kaszmirek/LinefollowerKaszmir/README.md

# LinefollowerKaszmir
robot typu line follower
