kaszmirek/LinefollowerKaszmir/Kaszmir/Kaszmir/KaszmirSensors/KaszmirSensors.step

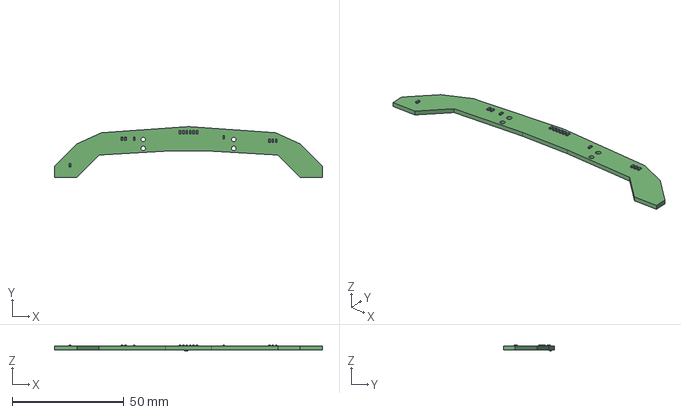
[picture p9: CAD file, 2021-05-30]
Kaszmir/Kaszmir/KaszmirSensors/KaszmirSensors.step
120.0 x 22.8 x 2.60 mm
