kaszmirek/LinefollowerKaszmir/Kaszmir/kicad-libs-master/kicad-libs-master/HYC04-TF09-200.step

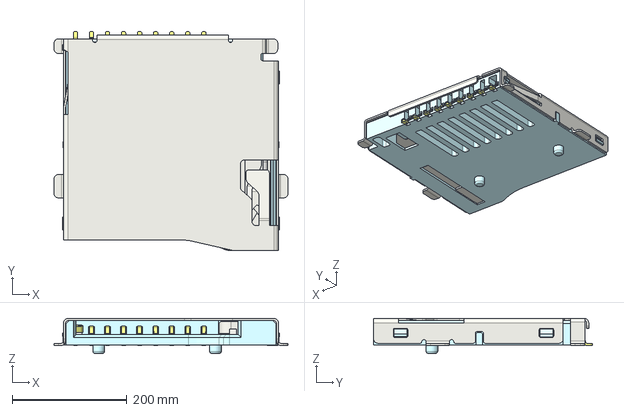
[picture p10: CAD file, 2021-05-30]
Kaszmir/kicad-libs-master/kicad-libs-master/HYC04-TF09-200.step
407.4 x 381.0 x 61.0 mm
