kaszmirek/LinefollowerKaszmir/Kaszmir_Inventor/pololu-2218-micro-metal-gearmotor-with-extended-motor-shaft-1.snapshot.1/Pololu #2218 Micro Metal Gearmotor HP.stp

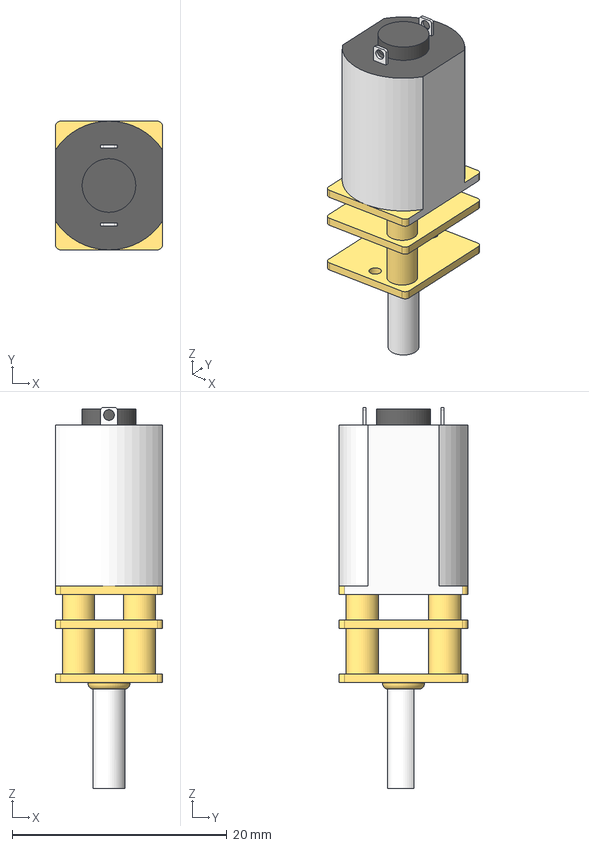
[picture p11: CAD file, 2021-05-30]
Kaszmir_Inventor/pololu-2218-micro-metal-gearmotor-with-extended-motor-shaft-1.snapshot.1/Pololu #2218 Micro Metal Gearmotor HP.stp
10.0 x 12.0 x 35.5 mm
