kaszmirek/LinefollowerKaszmir/Kaszmir_Inventor/pololu-micro-motor-bracket-1.snapshot.3/micro-motor-bracket.SLDPRT

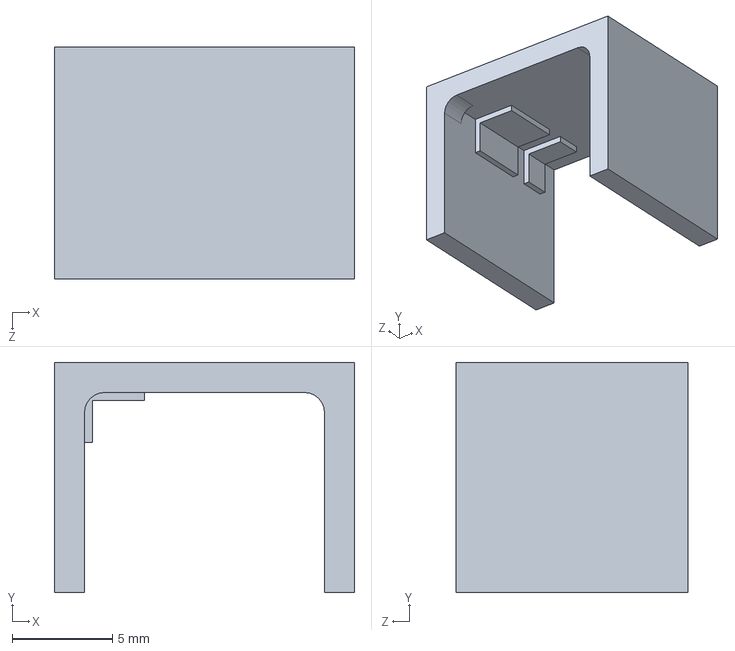
[picture p12: CAD file, 2021-05-30]
Kaszmir_Inventor/pololu-micro-motor-bracket-1.snapshot.3/micro-motor-bracket.SLDPRT
15.0 x 11.5 x 11.6 mm
