kaszmirek/LinefollowerKaszmir/Kaszmir_Inventor/wheel-solarbotics-rw2i-internally-mounted-1.snapshot.4/STEP/felga_solarbotics.STEP

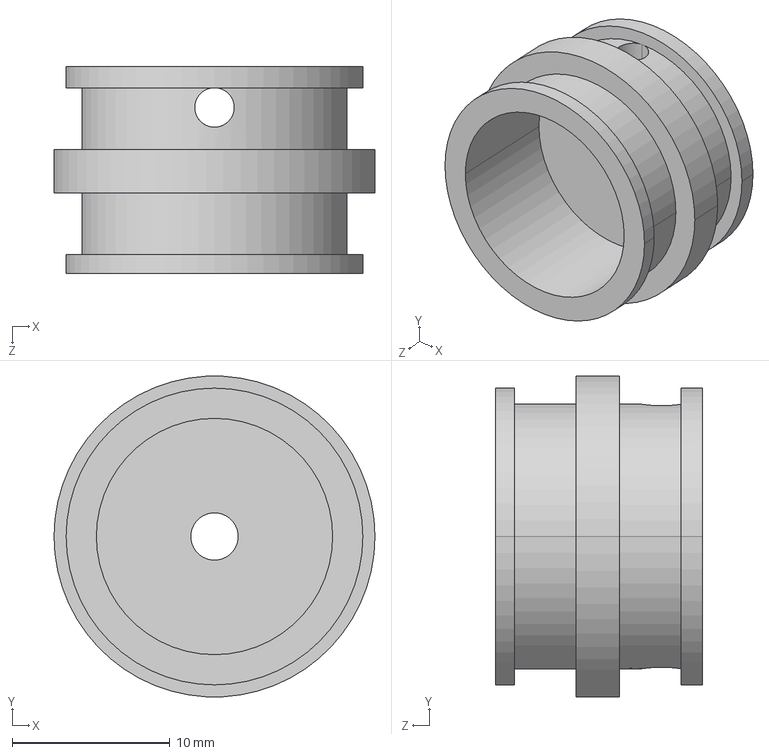
[picture p13: CAD file, 2021-05-30]
Kaszmir_Inventor/wheel-solarbotics-rw2i-internally-mounted-1.snapshot.4/STEP/felga_solarbotics.STEP
20.4 x 20.4 x 13.1 mm
