kaszmirek/LinefollowerKaszmir/Kaszmir/kicad-libs-master/kicad-libs-master/cap-size-code-g-v.stp

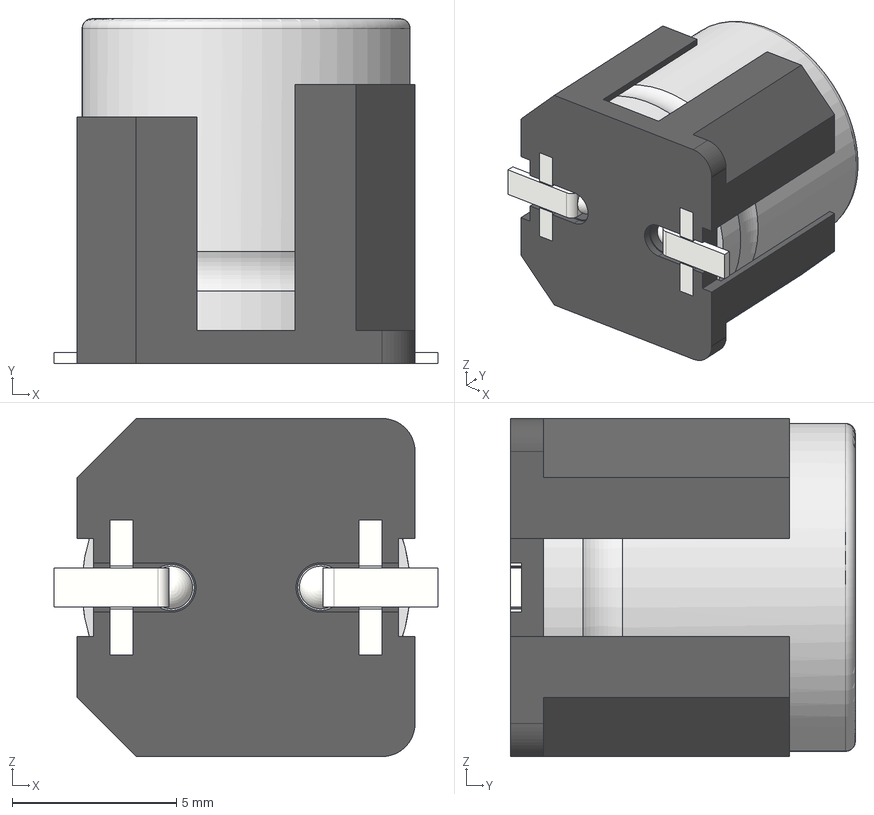
[picture p14: CAD file, 2021-05-30]
Kaszmir/kicad-libs-master/kicad-libs-master/cap-size-code-g-v.stp
11.7 x 10.5 x 10.3 mm
ケースΦ10x9.5L SIDE CODE G
耐振品座版Φ10 SIZE CODE G
耐振品座版用補助端子Φ10 SIZE CODE G x 2
耐振品リード線Φ10 SIZE CODE G x 2
