kaszmirek/LinefollowerKaszmir/Kaszmir_Inventor/pololu-micro-motor-bracket-1.snapshot.3/Bracket.IGS

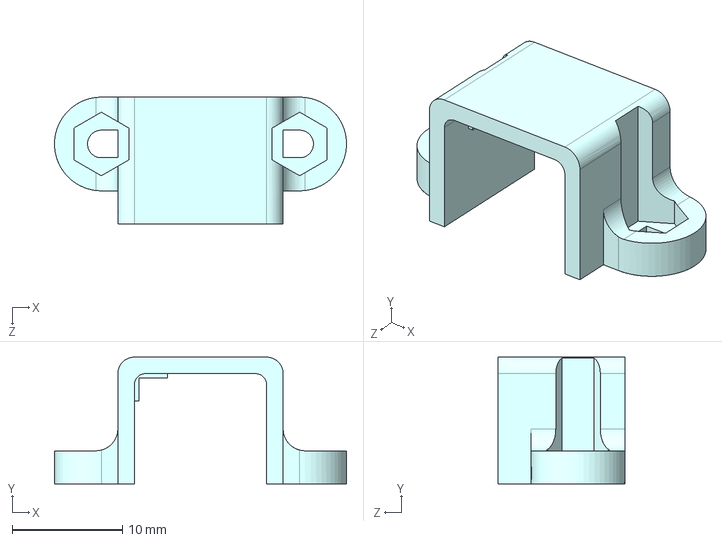
[picture p15: CAD file, 2021-05-30]
Kaszmir_Inventor/pololu-micro-motor-bracket-1.snapshot.3/Bracket.IGS
26.5 x 11.5 x 11.5 mm
