kaszmirek/LinefollowerKaszmir/Kaszmir/kicad-libs-master/kicad-libs-master/1TS003B.step

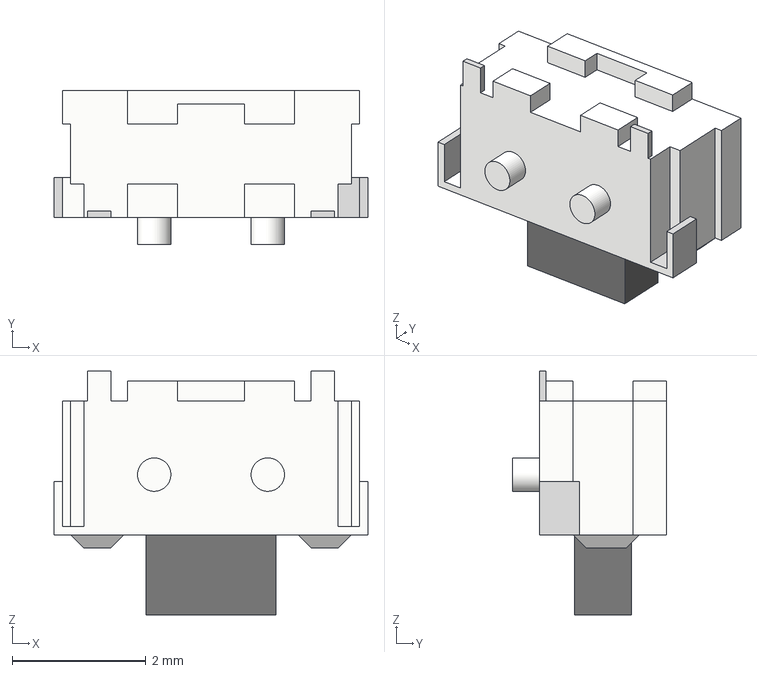
[picture p17: CAD file, 2021-05-30]
Kaszmir/kicad-libs-master/kicad-libs-master/1TS003B.step
4.70 x 2.30 x 3.65 mm
