kaszmirek/LinefollowerKaszmir/Kaszmir_Inventor/pololu-micro-motor-bracket-1.snapshot.3/Micro-Motor-Complet.IGS

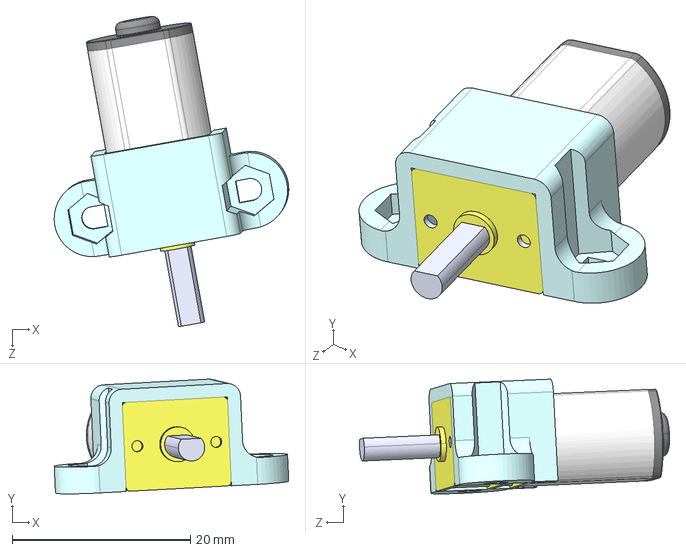
[picture p18: CAD file, 2021-05-30]
Kaszmir_Inventor/pololu-micro-motor-bracket-1.snapshot.3/Micro-Motor-Complet.IGS
26.3 x 12.9 x 34.8 mm
