kaszmirek/LinefollowerKaszmir/Kaszmir_Inventor/wheel-solarbotics-rw2i-internally-mounted-1.snapshot.4/STEP/opona solarbotics.STEP

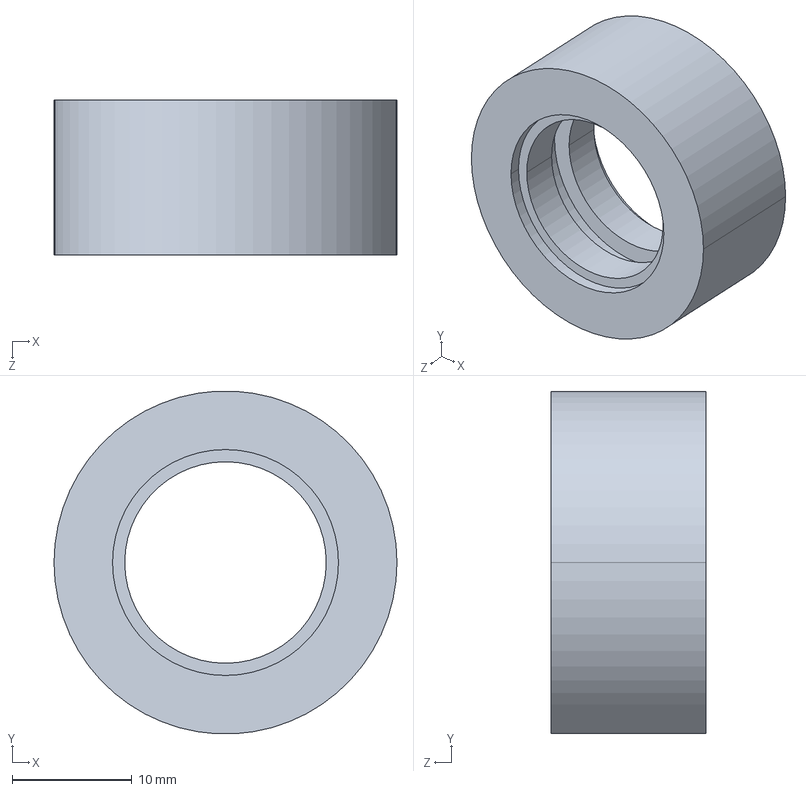
[picture p19: CAD file, 2021-05-30]
Kaszmir_Inventor/wheel-solarbotics-rw2i-internally-mounted-1.snapshot.4/STEP/opona solarbotics.STEP
28.6 x 28.6 x 13.0 mm
