kaszmirek/LinefollowerKaszmir/Kaszmir/kicad-libs-master/kicad-libs-master/WL-SFSW-155124M173200.stp

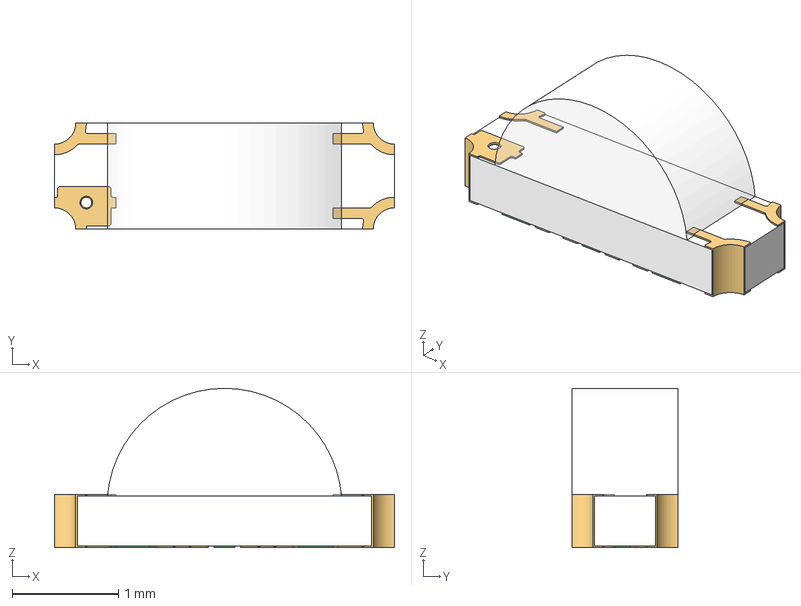
[picture p20: CAD file, 2021-05-30]
Kaszmir/kicad-libs-master/kicad-libs-master/WL-SFSW-155124M173200.stp
3.20 x 1.00 x 1.50 mm
housing
contacts
cap
