kaszmirek/LinefollowerKaszmir/(list of files, cad)

Other CAD files:
Kaszmir/Kaszmir/COMPOUND.ipt
Kaszmir/Kaszmir/C_0603_1608Metric.iam
Kaszmir/Kaszmir/Kaszmir.iam
Kaszmir/Kaszmir/KaszmirSensors/Bracket.ipt
Kaszmir/Kaszmir/KaszmirSensors/COMPOUND.ipt
Kaszmir/Kaszmir/KaszmirSensors/KaszmirSensors.iam
Kaszmir/Kaszmir/KaszmirSensors/R_0603_1608Metric.iam
Kaszmir/Kaszmir/KaszmirSensors/SOLID.ipt
Kaszmir/Kaszmir/LED_0603_1608Metric.iam
Kaszmir/Kaszmir/LQFP-64_10x10mm_P0.5mm.iam
Kaszmir/Kaszmir/PinHeader_1x02_P2.54mm_Vertical.iam
Kaszmir/Kaszmir/PinHeader_1x05_P2.54mm_Vertical.iam
Kaszmir/Kaszmir/PinHeader_1x08_P2.54mm_Vertical.iam
Kaszmir/Kaszmir/PinSocket_1x06_P2.54mm_Vertical.iam
Kaszmir/Kaszmir/R_0603_1608Metric.iam
Kaszmir/Kaszmir/SOLID.ipt
Kaszmir/Kaszmir/SOLID_1.ipt
Kaszmir/Kaszmir/SOLID_2.ipt
Kaszmir/Kaszmir/SOLID_3.ipt
Kaszmir/Kaszmir/SOLID_4.ipt
Kaszmir/Kaszmir/SOLID_5.ipt
Kaszmir/Kaszmir/SOLID_6.ipt
Kaszmir/Kaszmir/SOLID_7.ipt
Kaszmir/Kaszmir/SOLID_8.ipt
Kaszmir/Kaszmir/SOLID_9.ipt
Kaszmir/Kaszmir/SOT-23.iam
Kaszmir/Kaszmir/SW_SPST_B3U-1000P-B.iam
Kaszmir_Inventor/KaszmirCały.iam
Kaszmir_Inventor/OldVersions/KaszmirCały.0001.iam
Kaszmir_Inventor/listwa_weglowa.ipt
Kaszmir_Inventor/pololu-2218-micro-metal-gearmotor-with-extended-motor-shaft-1.snapshot.1/Pololu #2218 Micro Metal Gearmotor HP.ipt
Kaszmir_Inventor/pololu-micro-motor-bracket-1.snapshot.3/Bracket.STL
Kaszmir_Inventor/pololu-micro-motor-bracket-1.snapshot.3/Micro-Motor-Complet.STL
Kaszmir_Inventor/wheel-solarbotics-rw2i-internally-mounted-1.snapshot.4/STEP/koło_solarbotics.ipt
Kaszmir_Inventor/wheel-solarbotics-rw2i-internally-mounted-1.snapshot.4/felga_solarbotics.SLDPRT
Kaszmir_Inventor/wheel-solarbotics-rw2i-internally-mounted-1.snapshot.4/koło_solarbotics.SLDASM
Kaszmir_Inventor/wheel-solarbotics-rw2i-internally-mounted-1.snapshot.4/opona solarbotics.SLDPRT
