kaszmirek/LinefollowerKaszmir/Kaszmir/Kaszmir/Kaszmir.pdf

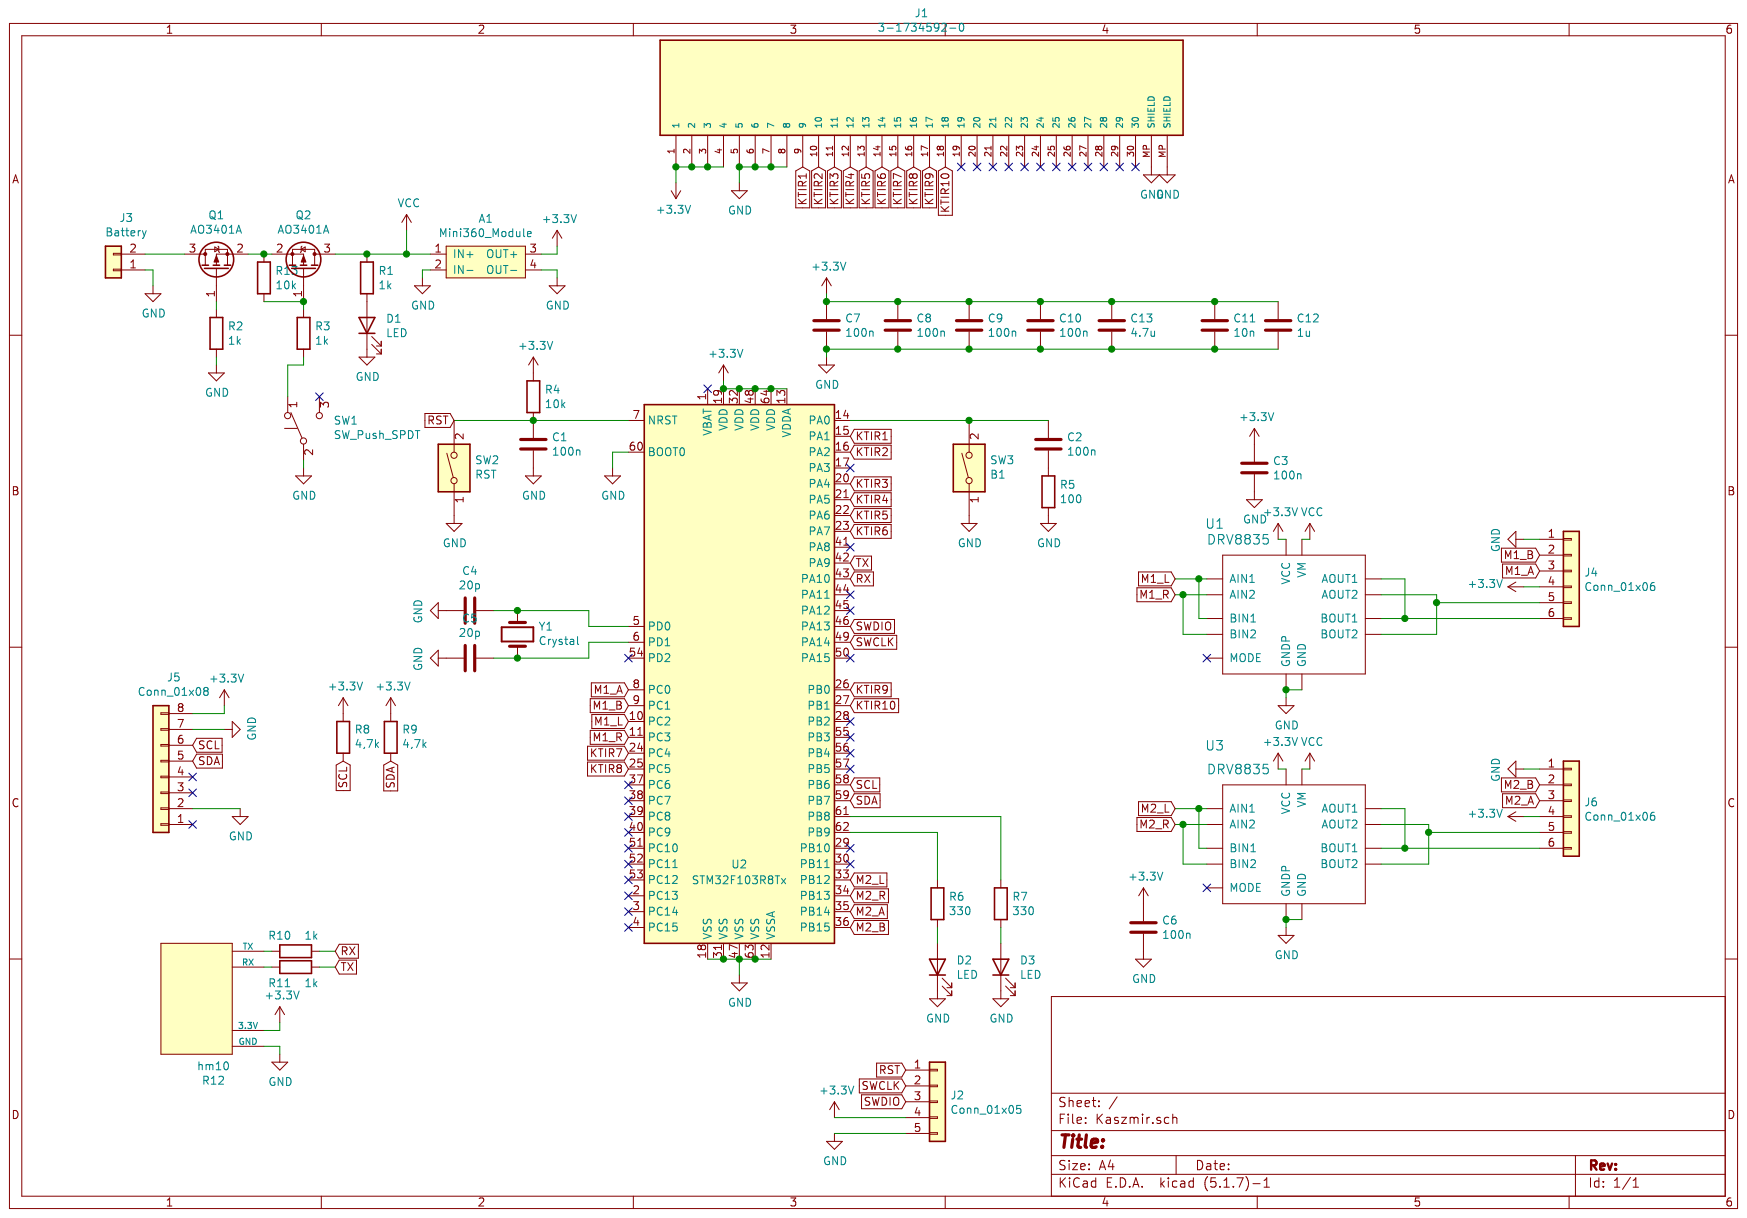
[picture p21: page 1]
