kaszmirek/LinefollowerKaszmir/Kaszmir/Kaszmir/KaszmirSensors.pdf

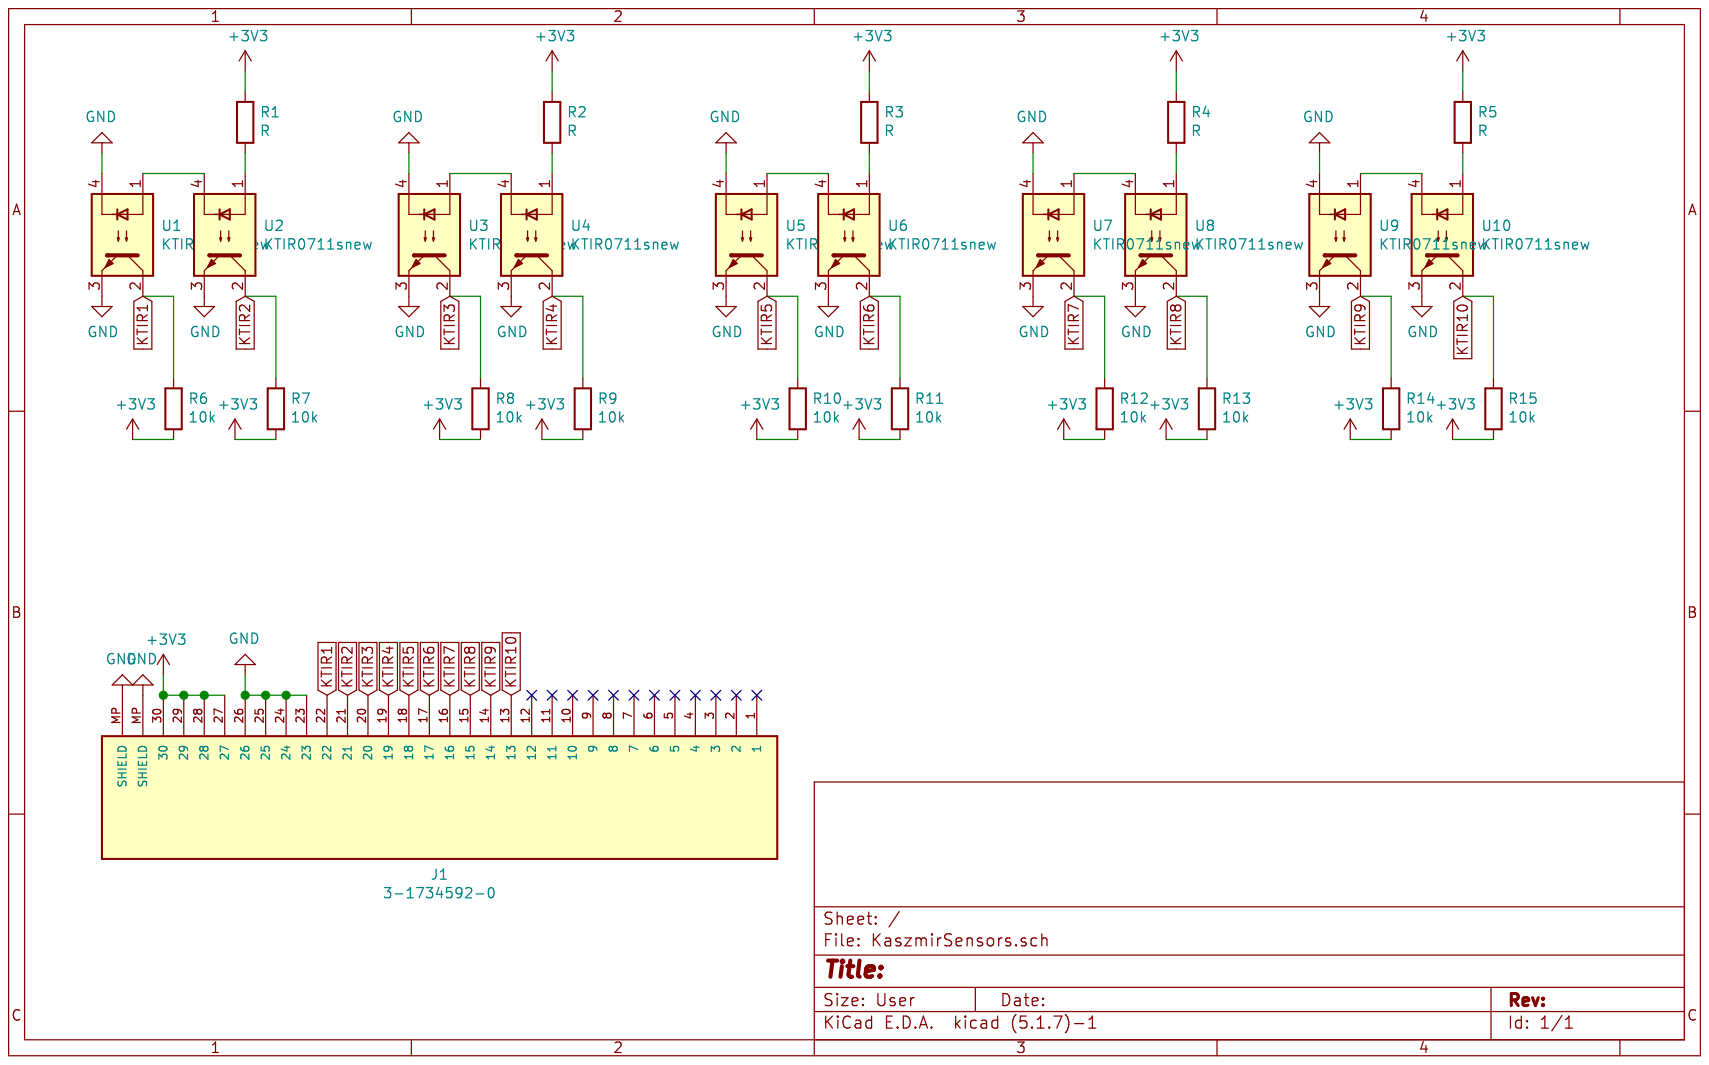
[picture p22: page 1]
