kaszmirek/LinefollowerKaszmir/Kaszmir/Kaszmir/KaszmirSensors/KaszmirSensors.kicad_pcb

## KiCad design Kaszmir/Kaszmir/KaszmirSensors/KaszmirSensors.kicad_pcb (2021-05-30)

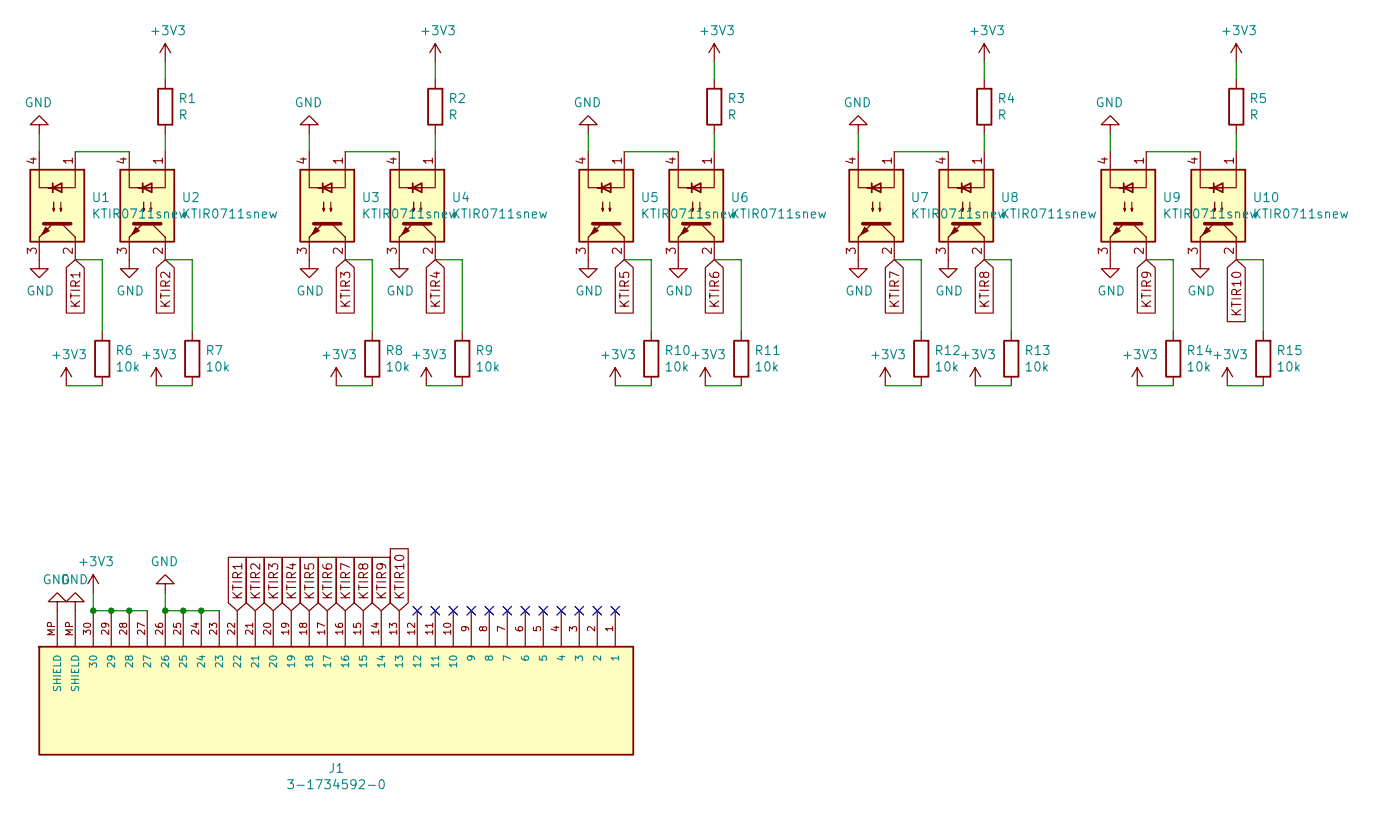
[picture p23: schematic KaszmirSensors.sch]

Parts:
J1: 3-1734592-0; TE_3-1734592-0; PARTREV C
R1, R2, R3, R4, R5: R; R_0603_1608Metric
R6, R7, R8, R9, R10, R11, R12, R13, R14, R15: 10k; R_0603_1608Metric
U1, U2, U3, U4, U5, U6, U7, U8, U9, U10: KTIR0711snew; KTIR0711s

Connections:
+3V3: J1.27, J1.28, J1.29, J1.30, R1.2, R2.2, R3.2, R4.2, R5.2, R6.1, R7.1, R8.1, R9.1, R10.1, R11.1, R12.1, R13.1, R14.1, R15.1
GND: J1.23, J1.24, J1.25, J1.26, J1.MP (SHIELD), U1.3, U1.4, U2.3, U3.3, U3.4, U4.3, U5.3, U5.4, U6.3, U7.3, U7.4, U8.3, U9.3, U9.4, U10.3
KTIR1: J1.22, R6.2, U1.2
KTIR2: J1.21, R7.2, U2.2
KTIR3: J1.20, R8.2, U3.2
KTIR4: J1.19, R9.2, U4.2
KTIR5: J1.18, R10.2, U5.2
KTIR6: J1.17, R11.2, U6.2
KTIR7: J1.16, R12.2, U7.2
KTIR8: J1.15, R13.2, U8.2
KTIR9: J1.14, R14.2, U9.2
KTIR10: J1.13, R15.2, U10.2
unnamed: R1.1, U2.1
unnamed: R2.1, U4.1
unnamed: R3.1, U6.1
unnamed: R4.1, U8.1
unnamed: R5.1, U10.1
unnamed: U1.1, U2.4
unnamed: U3.1, U4.4
unnamed: U5.1, U6.4
unnamed: U7.1, U8.4
unnamed: U9.1, U10.4

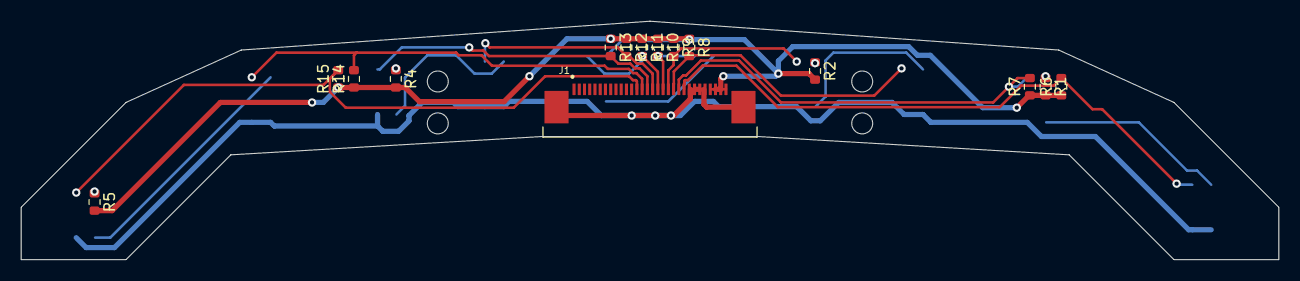
[picture p24: board KaszmirSensors.kicad_pcb from above]

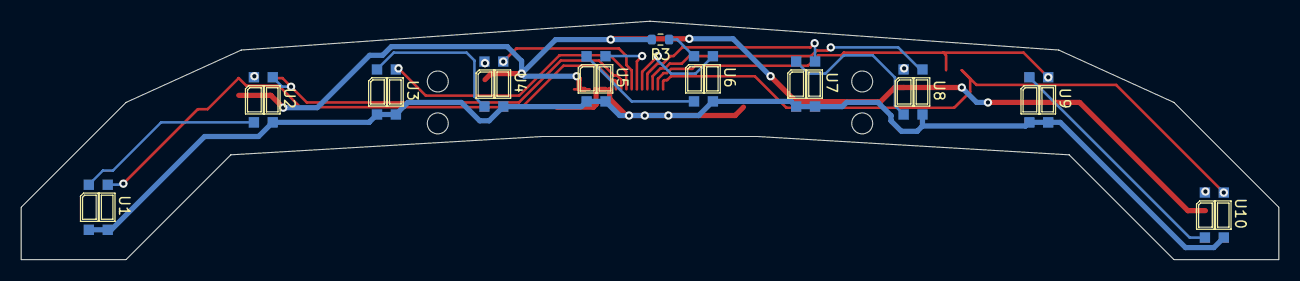
[picture p25: board KaszmirSensors.kicad_pcb from below]

Board: 2 copper layers, 120.0 x 22.8 mm, 26 parts (11 on the bottom side), 22 nets.
