kaszmirek/LinefollowerKaszmir/Kaszmir/Kaszmir/Kaszmir.kicad_pcb

## KiCad design Kaszmir/Kaszmir/Kaszmir.kicad_pcb (2021-05-30)

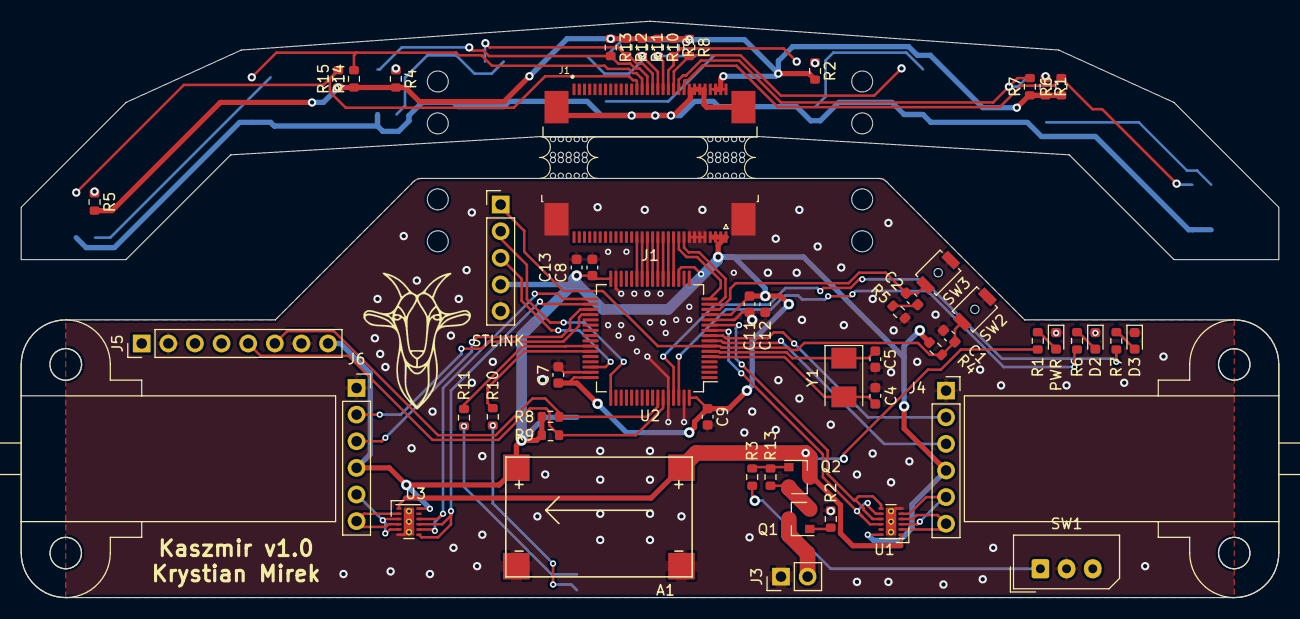
[picture p26: board Kaszmir.kicad_pcb from above]

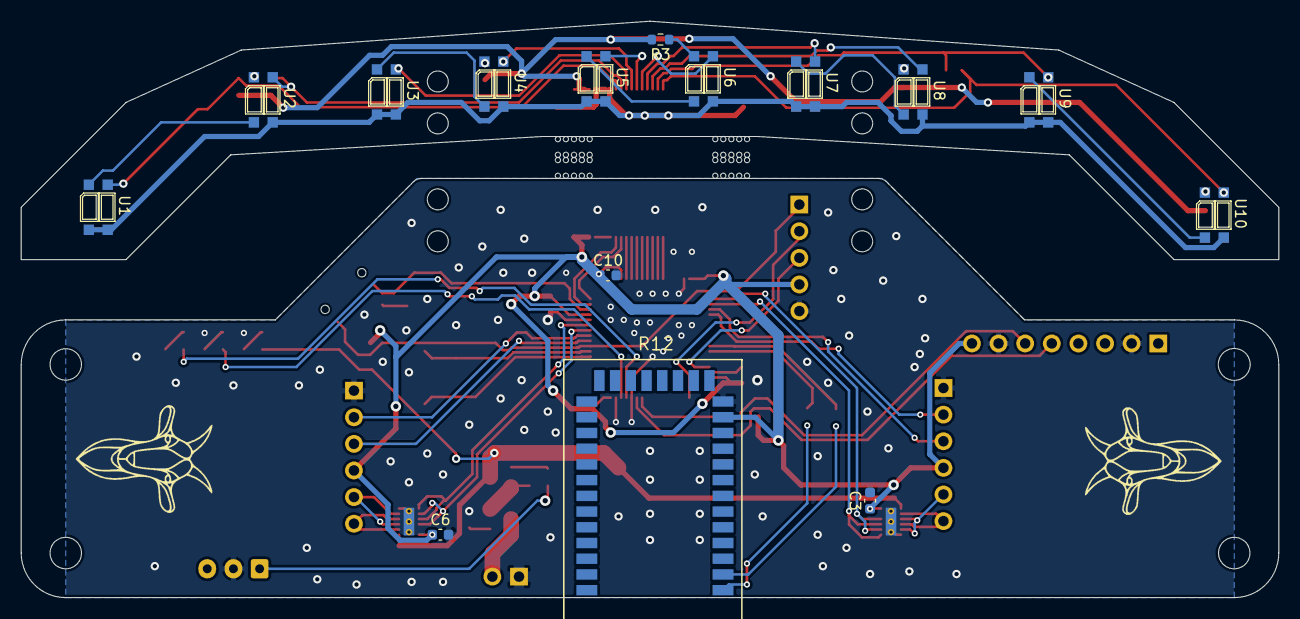
[picture p27: board Kaszmir.kicad_pcb from below]

Board: 2 copper layers, 120.0 x 55.0 mm, 75 parts (15 on the bottom side), 48 nets.

Parts:
A1: Mini360_Module
C1, C2, C3, C6, C7, C8, C9, C10: 100n; C_0603_1608Metric
C4, C5: 20p; C_0603_1608Metric
C11: 10n; C_0603_1608Metric
C12: 1u; C_0603_1608Metric
C13: 4.7u; C_0603_1608Metric
D1: PWR; LED_0603_1608Metric
D2, D3: LED; LED_0603_1608Metric
J1: 3-1734592-0; TE_3-1734592-0
J1#2: 3-1734592-0; TE_3-1734839-0_1x30-1MP_P0.5mm_Horizontal
J3: Battery; PinHeader_1x02_P2.54mm_Vertical
J4, J6: Conn_01x06; PinSocket_1x06_P2.54mm_Vertical
J5: Conn_01x08; PinHeader_1x08_P2.54mm_Vertical
Q1, Q2: AO3401A; SOT-23
R1, R2, R3, R4, R5: R; R_0603_1608Metric
R1#2, R2#2, R3#2, R10#2, R11#2: 1k; R_0603_1608Metric
R4#2, R6, R7, R8, R9, R10, R11, R12, R13, R13#2, R14, R15: 10k; R_0603_1608Metric
R5#2: 100; R_0603_1608Metric
R6#2, R7#2: 330; R_0603_1608Metric
R8#2, R9#2: 4,7k; R_0603_1608Metric
R12#2: hm10; HM10
STLINK: Conn_01x05; PinHeader_1x05_P2.54mm_Vertical
SW1: SW_Push_SPDT; Molex_SPOX_5267-03A_1x03_P2.50mm_Vertical
SW2: RST; SW_SPST_B3U-1000P-B
SW3: B1; SW_SPST_B3U-1000P-B
U1, U2, U3, U4, U5, U6, U7, U8, U9, U10: KTIR0711snew; KTIR0711s
U1#2, U3#2: DRV8835; WSON-12-1EP_3x2mm_P0.5mm_EP1x2.65_ThermalVias
U2#2: STM32F103R8Tx; LQFP-64_10x10mm_P0.5mm
Y1: Crystal; Crystal_SMD_5032-2Pin_5.0x3.2mm
mouse-bite-3mm-slot, mouse-bite-3mm-slot#2, mouse-bite-3mm-slot#3, mouse-bite-3mm-slot#4: VAL**; mouse-bite-3mm-slot

Connections:
+3V3: A1.3, C3.1, C6.1, C7.1, C8.1, C9.1, C10.1, C11.1, C12.1, C13.1, J1#2.1, J1#2.2, J1#2.3, J1#2.4, J4.4, J5.8, J6.4, R4#2.1, R8#2.2, R9#2.2, R12#2.12, STLINK.4, U1#2.12, U2#2.13, U2#2.19, U2#2.32, U2#2.48, U2#2.64, U3#2.12
GND: A1.2, A1.4, C1.2, C3.2, C4.2, C5.2, C6.2, C7.2, C8.2, C9.2, C10.2, C11.2, C12.2, C13.2, D1.1, D2.1, D3.1, J1#2.5, J1#2.6, J1#2.7, J1#2.8, J1#2.MP, J3.1, J4.1, J5.2, J5.7, J6.1, R2#2.2, R5#2.2, R12#2.13, STLINK.5, SW1.2, SW2.1, SW3.1, U1#2.6, U1#2.13, U2#2.12, U2#2.18, U2#2.31, U2#2.47, U2#2.60, U2#2.63, U3#2.6, U3#2.13
KTIR1: J1#2.9, U2#2.15
KTIR2: J1#2.10, U2#2.16
KTIR3: J1#2.11, U2#2.20
KTIR4: J1#2.12, U2#2.21
KTIR5: J1#2.13, U2#2.22
KTIR6: J1#2.14, U2#2.23
KTIR7: J1#2.15, U2#2.24
KTIR8: J1#2.16, U2#2.25
KTIR9: J1#2.17, U2#2.26
KTIR10: J1#2.18, U2#2.27
M1_A: J4.3, U2#2.8
M1_B: J4.2, U2#2.9
M1_L: U1#2.8, U1#2.10, U2#2.10
M1_R: U1#2.7, U1#2.9, U2#2.11
M2_A: J6.3, U2#2.35
M2_B: J6.2, U2#2.36
M2_L: U2#2.33, U3#2.8, U3#2.10
M2_R: U2#2.34, U3#2.7, U3#2.9
unnamed: C2.1, SW3.2, U2#2.14
unnamed: C2.2, R5#2.1
unnamed: C4.1, U2#2.5, Y1.2
unnamed: C5.1, U2#2.6, Y1.1
unnamed: D1.2, R1#2.2
unnamed: D2.2, R6#2.2
unnamed: D3.2, R7#2.2
unnamed: J3.2, Q1.3
unnamed: J4.5, U1#2.3, U1#2.5
unnamed: J4.6, U1#2.2, U1#2.4
unnamed: J6.5, U3#2.3, U3#2.5
unnamed: J6.6, U3#2.2, U3#2.4
unnamed: Q1.1, R2#2.1
unnamed: Q1.2, Q2.2, R13#2.1
unnamed: Q2.1, R3#2.1, R13#2.2
unnamed: R3#2.2, SW1.1
unnamed: R6#2.1, U2#2.62
unnamed: R7#2.1, U2#2.61
unnamed: R10#2.2, R12#2.1
unnamed: R11#2.2, R12#2.2
RST: C1.1, R4#2.2, STLINK.1, SW2.2, U2#2.7
RX: R10#2.1, U2#2.43
SCL: J5.6, R8#2.1, U2#2.58
SDA: J5.5, R9#2.1, U2#2.59
SWCLK: STLINK.2, U2#2.49
SWDIO: STLINK.3, U2#2.46
TX: R11#2.1, U2#2.42
VCC: A1.1, Q2.3, R1#2.1, U1#2.1, U3#2.1
